nasera21/Autonomous-RC-Harvester/eecs-452-john-wolvereene-master/2021-Team-8-report/README.txt

MDE PROJECT SUBMISSION FOR TEAM 8
SUBMITTED TOWARDS CREDIT FOR EECS 452 WINTER 2021
#################################################
Team: John Wolvereene (Team 8)
Team Members: Adithya Subbiah  - asubbiah@umich.edu
	      Katie Bertcher   - kbertch@umich.edu
	      Jack Winkelried  - jtwink@umich.edu
	      Maya Pandya      - mjpandya@umich.edu
	      Amir Naser       - afnaser@umich.edu
	      Elisabeth Jahnke - emjahnke@umich.edu

##################################################
##################################################

CONTENTS
	design							- Contains information to the RC Car hardware design
	src
		Arduino_Code 					- Contains all code for the Arduino
			Arduino_Custom_Libraries		- Contains Custom Libraries made for the Arduino Code
				Distance_Sensor_Library		- Library for the Distance Sensor
				RC_Car_Library			- Library for the RC Car
				UART_Library			- Library for the UART bus
			Arduino_Main				- Contains .ino file for the Arduino (main file)
		Raspberry_Pi_Code				- Contains all code for the Raspberry Pi
			finalCVClean.py				- "Main" python file for Raspberry Pi
			UART_Quantization.py			- UART quantization function library
			UART_rpiSerial.py			- UART bus library
		INSTALL.txt					- Installation instructions
		OVERVIEW.txt					- Overview of src folder
		USAGE.txt					- How to use code
	videos							- Contains all video files found in presentation (Demo Videos)
	2021-Team-8-poster.pdf					- Team 8 Poster
	2021-Team-8-slides.pdf					- Team 8 slide deck
	2021-Team-8-final.pdf					- Team 8 final report
	COPYRIGHT.txt						- Copyright licensing
