nasera21/Autonomous-RC-Harvester/eecs-452-john-wolvereene-master/2021-Team-8-report/2021-Team-8-slides.pdf

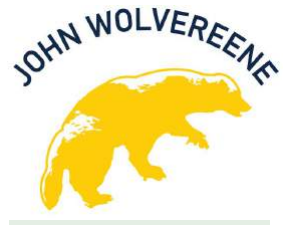
[picture p10: figure]

# Robotic Car to Navigate Natural Landscapes Final Presentation

Katie Bertcher, Elisabeth Jahnke, Amir Naser,

### Maya Pandya, Adithya Subbiah, Jack Winkelried

# Team 8: John Wolvereene

# Project Goal

## - This project demonstrated a precursor to an alternative smart harvesting technology by creating a vehicle capable of autonomously navigating a row of stakes

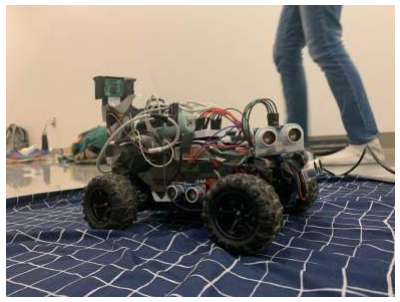
[picture p11: figure]

Our Autonomously Navigating Vehicle: John “Johnny” Wolvereene

# Project Background

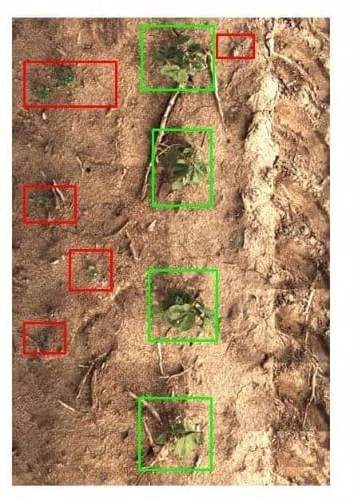
[picture p12: figure]

- Project Motivation Asparagus Harvesting
- Smart Harvesting
- Prominent application of signal processing in agriculture
- “See and Spray” technology for pesticide application
- The Asparagus Problem
- Sporadic, continuous growth prevents one big harvest
- Perennial plants, so important to avoid damage during harvest
- Around 75% of production costs come from labor
- Current Asparagus Harvesters
- Rail systems
- Trench systems
- No autonomously navigating vehicle systems (yet)

# Previous Work

- RC car hacking
- Precedent for hacking similar vehicles and using an arduino for control
■ Instructable by Mjrovai
- PID control for the RC car
- Precedence for PID controlled line and boundary following robots
■ | Past senior design from Cornell
■ | Arduino project hub information from Nova
- MatLab toolboxes and Simulink to design PID controllers
- Computer vision for distance detection
- Lab 2 as a starting point + additional object detection algorithms
■ | Histogram of Oriented Gradients
■ | Convolutional Networks
■ | You Only Look Once
- Using the focal length of the camera to calculate distance
■ | Starter source code from Mahbub
■ | If this is not sufficient, stereovision with
| two cameras is an option
- UART communication with distance sensor
■ | Instructions online for arduino to pi
| communication

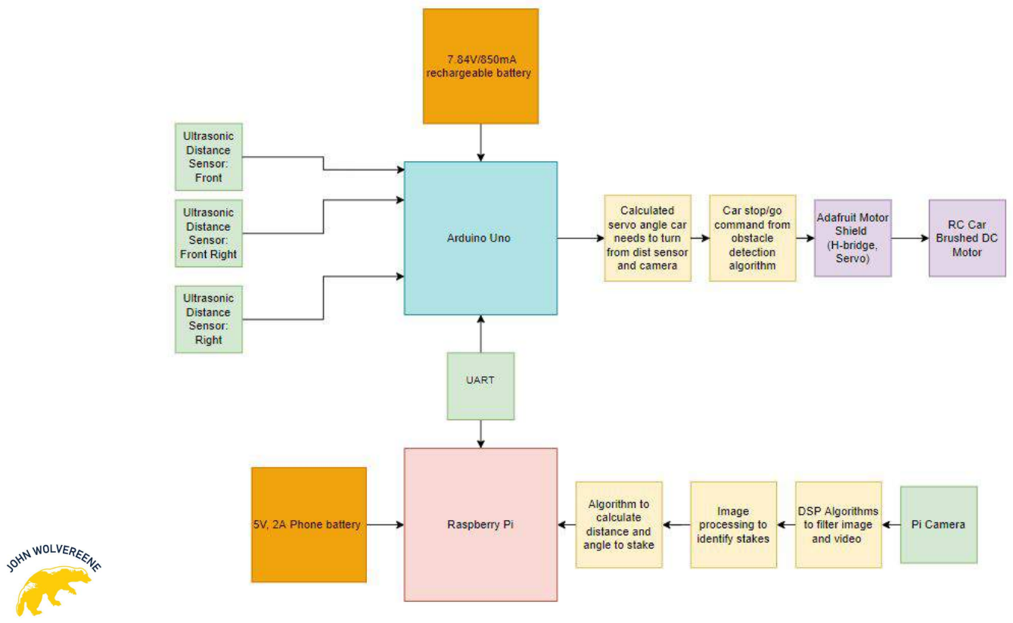
[picture p13: page 5]

# RC Car Hardware Method

## - Drive System

- Original RC Car Brushed DC Motor
- Adafruit Motor Shield + Arduino provides speed control
- Duty Cycle + Directional control via H-bridge

## - Steering System

- Original RC car steering linkage
- Servo motor drives linkage
- Roughly 90 degree steering span

## - Wrote custom RC Car software library for easy interfacing

# RC Car Hardware Method

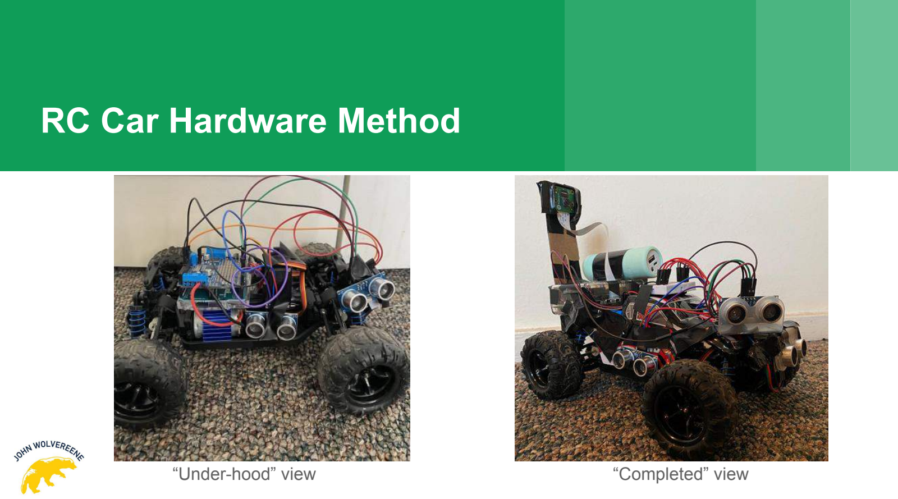
[picture p14: page 7]

“Under-hood” view | “Completed” view

# Control System: Method

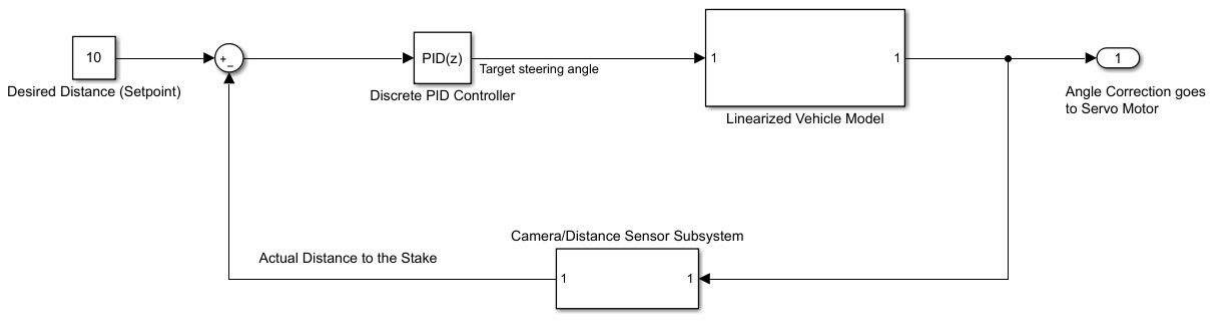
[picture p15: figure]

# Control System: PID Equations

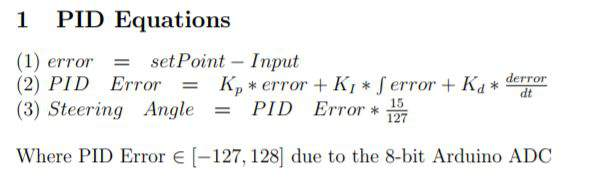
[picture p16: figure]

# Control System: PID Tuning

### - Used Ziegler-Nichols Tuning Rules in our Matlab/Simulink Simulation to get PID gains to start with - Tuned the gains as we viewed the car’s behavior along the stakes/wall

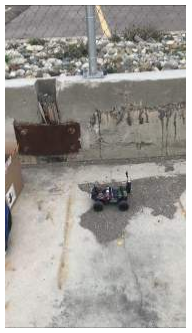
[picture p17: figure]
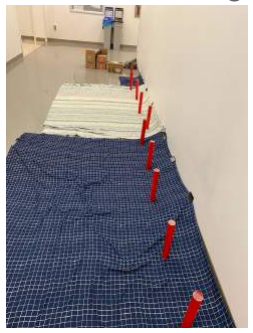
[picture p18: figure]

# Distance Sensor Library

## - Wrote custom wrapper for distance sensor library

- Three Sensors (Right, Front Right, Front)

## - Measures the median time of 5 sample points - Converted return time from sensors to a distance (units of inches) - Equation:

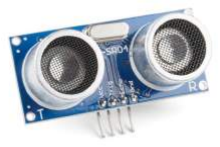
[picture p19: figure]

- Distance = (((Duration_measured) / 2)* speed_sound_cm) / 2.54

# Obstacle Detection

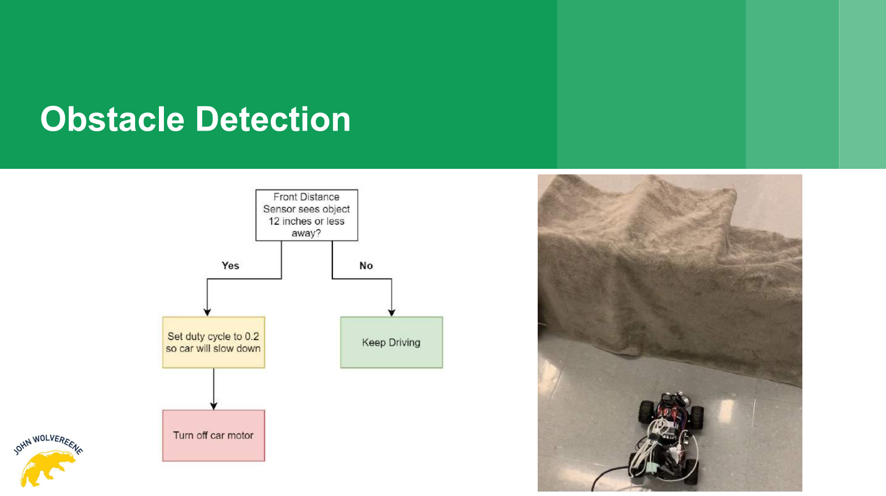
[picture p20: page 12]

# UART Method

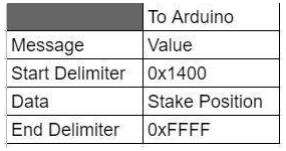
[picture p21: figure]

## - Wrote custom UART library

- Used Start and End delimiters for packet definition
- Arduino sends a GPIO High to Raspi to indicate Ready
■ | Used as a fix for buffer overflow issue
■ | A future solution is to use an interrupt routine
- Library contains easy to interface functions for CV code

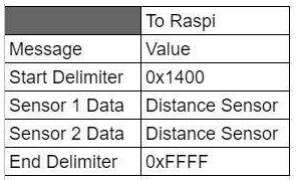
[picture p22: figure]

# CV Stake Detection Method

Use findContours after using H, V, R, B thresholding on the image.

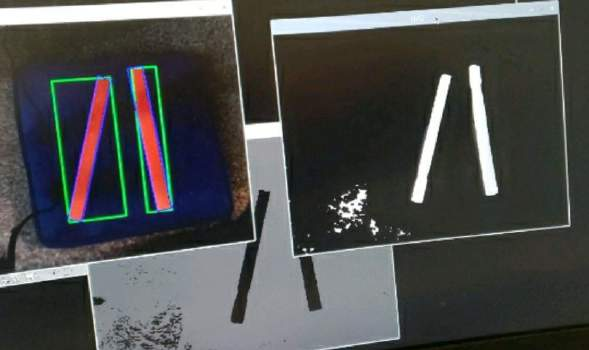
[picture p23: figure]

Draws a vertical box around the whole stake, and another box that will outline the stake (even if it is at an angle).

Gain values for the width of the stakes and the distance between the center of the stake to the center of the image for use in distance calculations

# CV Distance Calculation Method

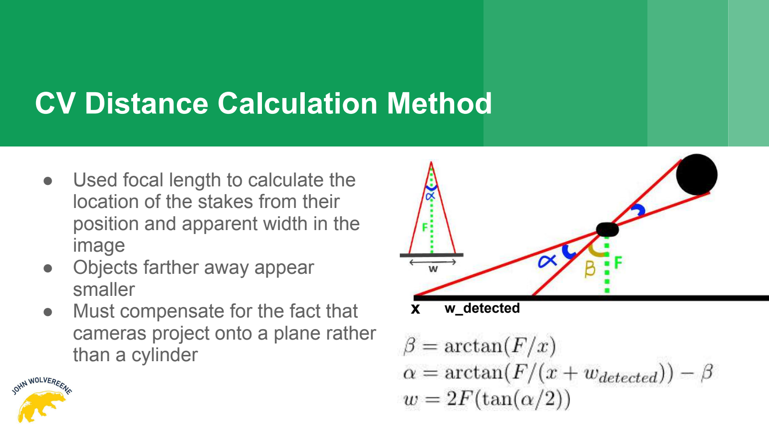
[picture p24: page 15]

## - Used focal length to calculate the location of the stakes from their position and apparent width in the image - Objects farther away appear smaller - Must compensate for the fact that cameras project onto a plane rather than a cylinder

x w_detected

# CV Distance Calculation Method

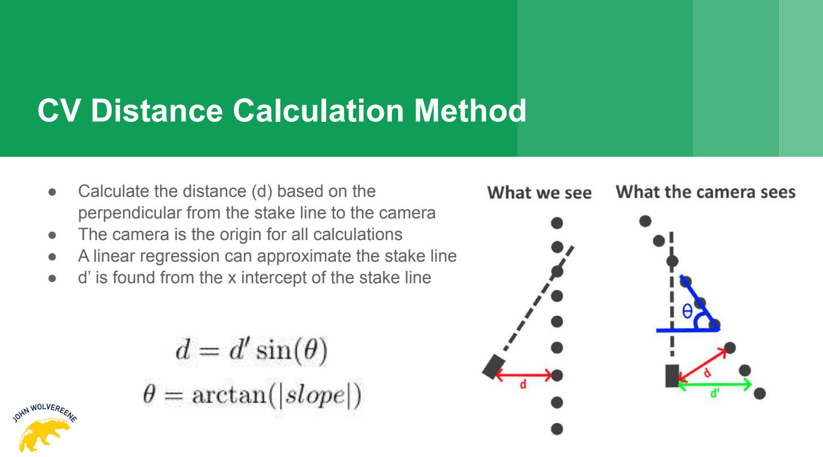
[picture p25: page 16]

- Calculate the distance (d) based on the perpendicular from the stake line to the camera
- The camera is the origin for all calculations
- A linear regression can approximate the stake line
- d’ is found from the x intercept of the stake line

# Demo!

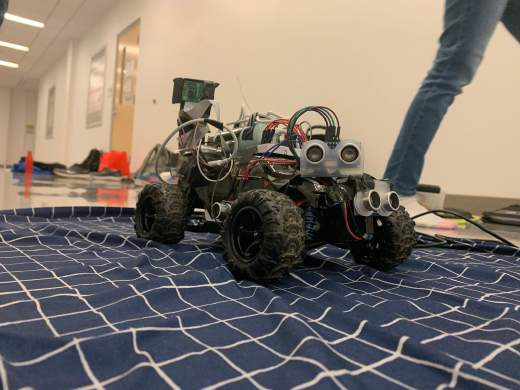
[picture p26: figure]

## - Car Headless With Obstacle Detection (https://youtu.be/stfk3D8UFYg) - Car Run 1 (https://youtu.be/Whw9r8eeo1E) - Car Run 2 (https://youtu.be/2RpbXtygMvY) - Car Diagonal (https://youtu.be/VWoOB1HchAo) - Curve Run (https://youtu.be/dP3ApOmQ7hc) - Camera Perspective (https://youtu.be/MKfYrmqDSXI)

# Project Results

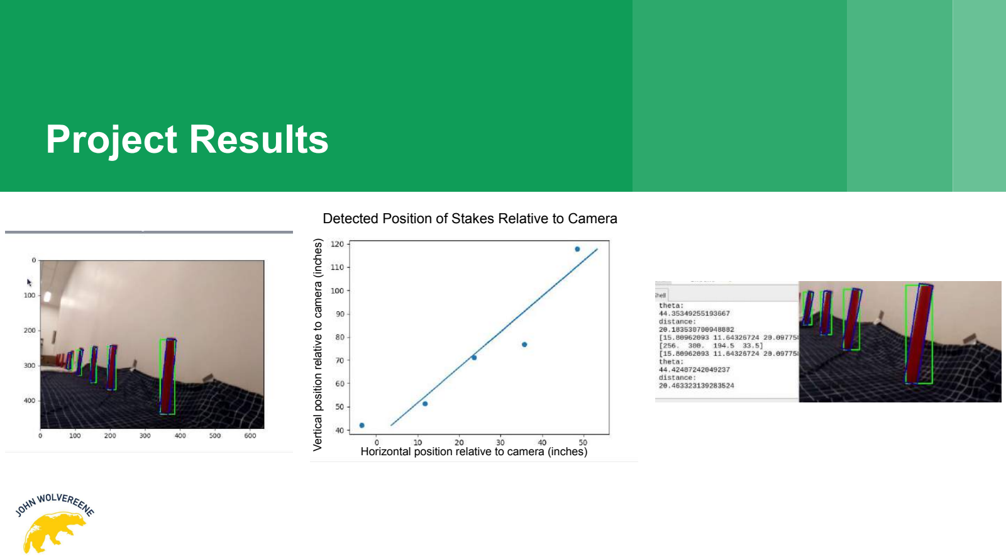
[picture p27: page 18]

Detected Position of Stakes Relative to Camera

Horizontal position relative to camera (inches)

Vertical position relative to camera (inches)

# Technical Highlights

- Created our own custom PID loop without any Arduino Libraries - Took a consumer RC Car and were able to successfully modify it to work with our system architecture - Implemented robustness in our CV architecture by throwing out outliers and allowing the stakes to be detected even at angles - Unlike a path following robot, our robot actually takes non-defined obstacles and creates a line to follow from the data

- It did not have a clear defined path, it had to create its own path from environmental objects

# Technical Highlights

### What we wish we knew going into the project!

### - CV Detection is extremely sensitive to lighting conditions - The PiCamera uses a pinhole camera model - Approximating a nonlinear system as linear only gets you so far in control theory

- Car Cannot correct horizontally

### - Discovered UART buffer overflow on Arduino

- Caused by the Raspi sending commands faster than the Arduino can process
- Solved by Arduino sending a 1 on a GPIO to the Raspi when ready for new data

## Project Poster

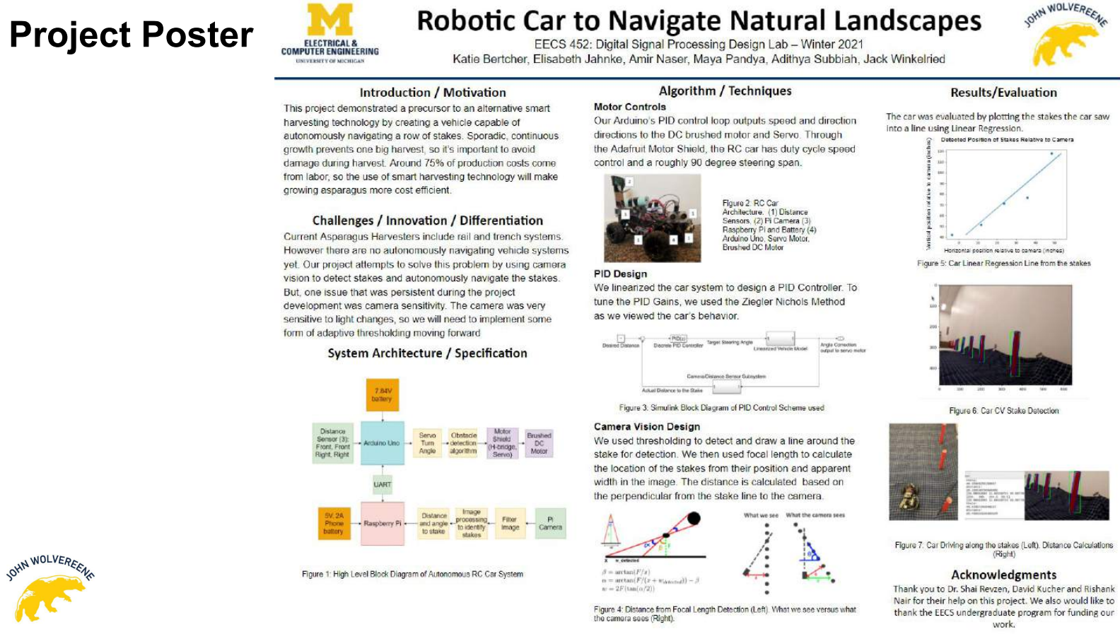
[picture p28: page 21]

# References

[1] Chong, Bonnie, et al. “ECE 4760 The Autonomous Driving Car.” Cornell ECE, Cornell, people.ece.cornell.edu/land/courses/ece4760/FinalProjects/s2011/bcc44_acl84_my259/bcc44_acl84 _my259/index.html.

[2]GARotics, European Union’s Seventh Framework Programme, 2012, www.amlight.eu/garotics.php.

[3] Khvoynitskaya, Sandra. “3 Types of Autonomous Vehicle Sensors in Self‑Driving Cars.” Itransition, Itransition, 2 Nov. 2020,
www.itransition.com/blog/autonomous-vehicle-sensors#:~:text=The%20majority%20of%20today%27 s%20automotive,cameras%2C%20radars%2C%20and%20lidars.
[4] Mahbub, Istiaq. “Distance Measurement.” MD Istiaq Mahbub, Wix, istiaqmahbub.wixsite.com/embedded/distance-measurment.

# References

[5] Mjrovai, “Hacking a RC Car With Arduino and Android.” Instructables, Autodesk, 28 Sept. 2017, www.instructables.com/Hacking-a-RC-Car-With-Arduino-and-Android/.
[6] Nova. “Line Follower Robot (with PID Controller).” Arduino Project Hub, Arduino, 11 Aug. 2020, create.arduino.cc/projecthub/anova9347/line-follower-robot-with-pid-controller-cdedbd.
[7] Satran, Joe. “Most Of Your Asparagus Comes From Abroad These Days. Here's Why.” HuffPost, HuffPost, 7 Dec. 2017, www.huffpost.com/entry/asparagus-farms-california_n_7029836.
[8] See & Spray Agricultural Machines - Blue River Technology, Blue River Technology, www.bluerivertechnology.com/.
[9] Zitter, Leah. “Inaho's Tireless Asparagus Picking Robot.” Food and Farming Technology, 15 Oct. 2020, www.foodandfarmingtechnology.com/news/yield-monitoring/inahos-tireless-asparagus-picking-robot .html.

## Thank you! Questions?

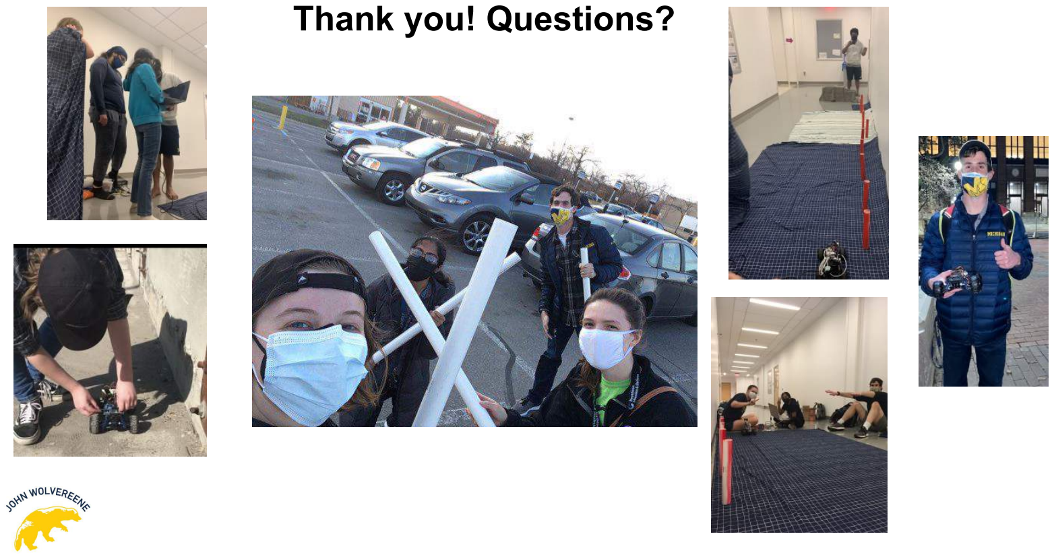
[picture p29: page 24]
