nasera21/Autonomous-RC-Harvester/eecs-452-john-wolvereene-master/2021-Team-8-report/design/Team_8_Parts_List.xlsx

Material | Quantity | Cost | Link
RC Car | 1.00 | $68 | https://www.amazon.com/dp/B07XP8DJSY/?coliid=I3BTHIPIE0KNQ&colid=EZH0BUSYUJ1
Adafruit Motor Shield | 1.00 | 0 | provided
Arduino Uno | 1.00 | 0 | provided
Dc Barrel Jack | 1.00 | $7 | Amazon.com: CCYC DC 5V DC Barrel Jack Power Cable, USB to DC Jack 5.5 x 2.5(2.1) mm, for Fan, Led Light, Wireless Router, Speakers and More Device: Home Audio & Theater (https://www.amazon.com/gp/product/B079K2DS3H/ref=ppx_od_dt_b_asin_title_s00?ie=UTF8&psc=1)
Raspberry Pi | 1.00 | 0 | Provided
Pi Camera | 1.00 | 0 | Provided
Arduino Ultrasonic Dist. Sensor | 3.00 | $9 | https://www.amazon.com/Hailege-HC-SR04-Ultrasonic-Distance-MEGA2560/dp/B08BLLRK5X
