nasera21/Autonomous-RC-Harvester/eecs-452-john-wolvereene-master/2021-Team-8-report/src/INSTALL.txt

INSTALLATION INSTRUCTIONS

	Raspberry Pi:
		Necessary libraries to be installed:
			Python 3
			picamera
			cv2
			time
			matplotlib
			numpy
			serial
			RPi.GPIO
			sklearn

	Arduino:
		Necessary libraries to be installed:
			DistanceSensorLib - custom
			RCCarLib	  - custom
			carSerial	  - custom
			NewPing

Once all libraries are installed:

For Arduino:
	Upload PID_Controller_with_car_Final.ino to the Arduino Uno

For Raspberry Pi:
	Execute script using command: "python3 finalCVClean.py"
