nasera21/Autonomous-RC-Harvester/eecs-452-john-wolvereene-master/Distance Sensor/sample_code_two_sensors.ino

 /* Dual HC-SR04 with Temp and Humidity Demonstration
  HC-SR04-Temp-Humid-Dual-Demo.ino
  Demonstrates enhancements of HC-SR04 Ultrasonic Range Finder
  With DHT22 Temperature and Humidity Sensor
  Displays results on Serial Monitor
 
  DroneBot Workshop 2017
  http://dronebotworkshop.com
*/
 

 
// Include NewPing Library
#include "NewPing.h"
 
// Define Constants
 
#define TRIGGER_PIN_1  10
#define ECHO_PIN_1     11
#define TRIGGER_PIN_2  9
#define ECHO_PIN_2     8
#define MAX_DISTANCE 400
 
NewPing sonar1(TRIGGER_PIN_1, ECHO_PIN_1, MAX_DISTANCE);
NewPing sonar2(TRIGGER_PIN_2, ECHO_PIN_2, MAX_DISTANCE);
 
// Define Variables
float duration1; // Stores First HC-SR04 pulse duration value
float duration2; // Stores Second HC-SR04 pulse duration value
float distance1; // Stores calculated distance in cm for First Sensor
float distance2; // Stores calculated distance in cm for Second Sensor
float soundsp;  // Stores calculated speed of sound in M/S
float soundcm;  // Stores calculated speed of sound in cm/ms
int iterations = 5;
 
// Initialize DHT sensor for normal 16mhz Arduino
 
void setup() {
  Serial.begin (9600);
}
 
void loop()
{
 
  delay(1000);  
    // Calculate the Speed of Sound in M/S
    soundsp = 331.4;
    // Convert to cm/ms
    
  soundcm = soundsp / 10000;
  
  // Measure duration for first sensor
    
  duration1 = sonar1.ping_median(iterations);
  
  // Add a delay between sensor readings
  
  delay(1000);
  
  // Measure duration for first sensor
  
  duration2 = sonar2.ping_median(iterations);
  
  // Calculate the distances for both sensors
  
  distance1 = (duration1 / 2) * soundcm;
  distance2 = (duration2 / 2) * soundcm;
  
  // Send results to Serial Monitor
  
    Serial.print("Distance 1: ");
 
    if (distance1 >= 400 || distance1 <= 2) {
    Serial.print("Out of range");
    }
    else {
    Serial.print(distance1);
    Serial.print(" cm ");
    }
    
    Serial.print("Distance 2: ");
 
    if (distance2 >= 400 || distance2 <= 2) {
    Serial.print("Out of range");
    }
    else {
    Serial.print(distance2);
    Serial.print(" cm");
    }
  
  Serial.println(" ");
}
