nasera21/Autonomous-RC-Harvester/eecs-452-john-wolvereene-master/2021-Team-8-report/design/Servo_linkage.jpg

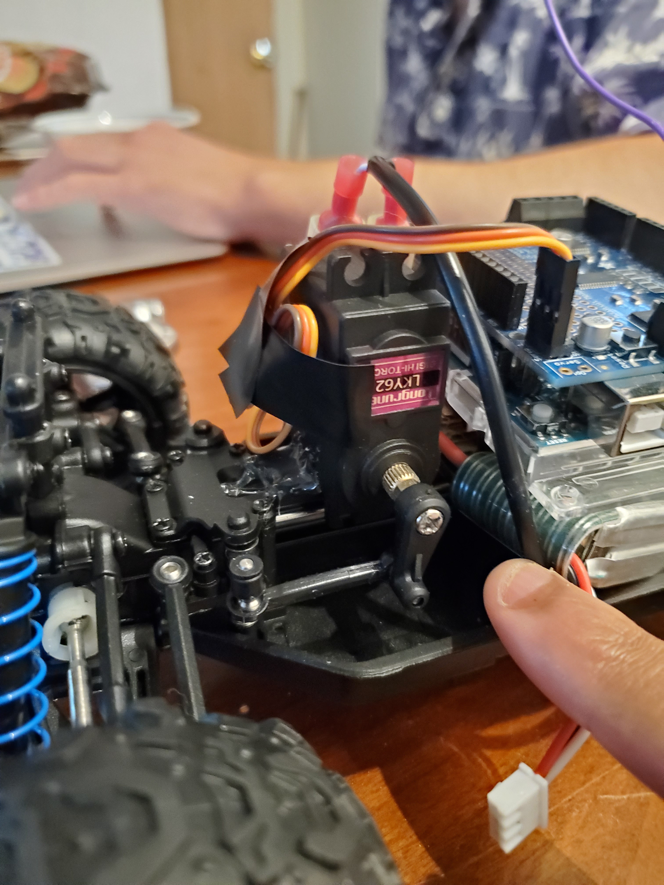
eecs-452-john-wolvereene-master/2021-Team-8-report/design/Servo_linkage.jpg
